dhsmith111/neato-build/docs/BOM.md

# Bill of Materials

## Neato Restoration
| Item | Source |
|---|---|
| NASTIMA 7.2V 5200mAh Li-ion Battery 2-pack | Amazon |
| Amazon Basics USB-A to Mini USB 2.0 Cable 3ft | Amazon |
| Filter + Brush Roll kit | Skipped for now |

## Raspberry Pi Core + AI
| Item | Source |
|---|---|
| CanaKit Pi 5 8GB GenAI Kit Assembled (Pi 5 8GB, AI HAT+ 2 Hailo-10H 40 TOPS, Turbine Case, Active Cooler, secondary Hailo fan, 128GB microSD, HDMI cables) | CanaKit |
| 27W GaN PD USB-C Power Supply with inline on/off switch | Amazon |

## Cameras
| Item | Source |
|---|---|
| Raspberry Pi Camera Module 3 Wide | pishop.us |
| Raspberry Pi Camera Module 3 Wide NoIR | pishop.us |
| Camera Cable for Raspberry Pi 5, 500mm x2 | pishop.us |

## Power & Wiring
| Item | Source |
|---|---|
| SunFounder 2 Channel DC 5V Relay Module | Amazon |
| ELEGOO 120pcs Dupont Wire Kit (M-F, M-M, F-F) | Amazon |
| Breadboard and Jumper Wires Kit (830 + 400 tie point) | Amazon |
| Ginsco 580pcs Heat Shrink Tubing Kit | Amazon |
| Yahboom PD Power Expansion Board for Pi 5 (6-24V in, 5V/5A PD out) | Amazon |

## Mounting & Wiring
| Item | Source |
|---|---|
| PATIKIL Sticky PCB Spacer Adhesive Standoffs 0.31" 24-pack | Amazon |
| Zip Tie Assortment multisize | Amazon |
| VELCRO Brand Heavy Duty Strips 4x2" 15 sets | Amazon |
| BNTECHGO 18 AWG Silicone Wire 5ft red + 5ft black | Amazon |
| HUIQIAODS Inline Fuse Holder 18 AWG + 5A fuse 2-pack | Amazon |
