dhsmith111/neato-build/(commit log)

2026-03-22 Add relay and serial test scripts, update requirements
    - relay_test.py: basic VBUS toggle test (fixed active_high=True)
    - serial_test.py: full power cycle + GetVersion over serial
    - requirements.txt: add gpiozero and lgpio (Pi 5 GPIO backend)
    [relay_test.py, serial_test.py]
2026-03-22 Add neato_serial library for Neato XV serial control
    Rename serial/ to neato_serial/ to avoid shadowing pyserial.
    Neato class wraps relay power cycle, serial connection, and all
    common commands (GetVersion, GetCharger, GetAccel, TestMode,
    SetMotor, GetLDSScan, SetLDSRotation, SetConfig).
    [neato.py]
2026-03-22 Add mounting layout diagram for Pi + camera on Neato
    SVG shows top and side views of component placement:
    Pi 5 + AI HAT+ 2 + camera stacked on LiDAR cover,
    relay and buck converter behind Pi toward rear.
2026-03-22 Add project documentation: BOM, power, wiring, setup
    Capture key technical decisions and hardware details in docs/:
    - BOM.md: complete parts list and costs
    - POWER.md: Yahboom PD board choice, battery specs, wiring plan
    - WIRING.md: relay pinout, serial, camera connections
    - SETUP.md: software stack, robot config, troubleshooting
    Update README power info and add docs links.
2026-03-22 Update README with full project description, clean up .gitignore
    Rewrite README with detailed project intro, architecture overview,
    and expanded stage descriptions. Add gitignore rules for test
    captures, lgpio temp files.
2026-03-22 Remove prices from public BOM, keep parts list only
2026-03-22 Remove LM2596 from BOM — replaced by Yahboom PD board
2026-03-22 Document venv --system-site-packages requirement for picamera2
    Add setup logs for all stages, document Hailo-10H driver install
    (h10- packages required, not generic hailo-), update BOM.
2026-03-22 Add vision pipeline: camera capture + YOLOv8m on Hailo-10H at 21 FPS
    Stage 3 core modules:
    - vision/capture.py: Camera class wrapping picamera2
    - vision/detector.py: Detector class using Hailo async InferModel API
    - vision/detect_test.py: single-frame detection test with bbox overlay
    - vision/benchmark.py: sustained FPS measurement (50 frames)
    Documented Hailo-10H API research in SETUP.md — the old InferVStreams
    API fails on H10, must use picamera2's Hailo wrapper (create_infer_model).
    [benchmark.py, capture.py, detect_test.py, detector.py]
2026-03-22 Add capture session manager and gitignore captures/
    - vision/session.py: timestamped folders under captures/ to prevent overwrites
    - .gitignore: exclude captures/ directory (test images only)
    [session.py]
2026-03-23 Add Stage 4: reactive obstacle avoidance + firmware behavior analysis
    Scout module — closed-loop detect-decide-drive pipeline:
    - scout/perception.py: fuse YOLO detections + hardware sensors into Snapshot
    - scout/rules.py: prioritized reactive rules (cliff > bumper > wall > pet > obstacle)
    - scout/driver.py: Action → Neato motor commands + dead-reckoning odometry
    - scout/sensors.py: background thread polls bumpers, wall IR, cliff, accel
    - scout/feedback.py: diagnostic LED + sound feedback per safety layer
    - scout/logger.py: session + breadcrumb logging for Stage 5 SLAM prep
    - main.py: orchestrator with capture → detect → perceive → decide → execute loop
    - config/scout.json: all tu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
    [analyze_clean_log.py, log_clean_mode.py, neato.py]
2026-04-05 Document battery power tap wiring for Yahboom PD board
    Documents the XV Signature Pro disassembly process, internal series
    battery wiring, Wago 221-413 tap method, and Yahboom KF301 connection.
2026-04-05 Add MOUNTING.md with 3D printed pod plan and component specs
    Documents electronics pod design intent, component dimensions, printer
    specs, and TODO list for when the Ender 3 calibration session happens.
2026-04-05 Update MOUNTING.md with OpenSCAD workflow for pod design
    Replace FreeCAD/Fusion360 with OpenSCAD code-based approach so Claude
    can write the design directly from measurements.
2026-04-05 Update MOUNTING.md with final pod layout and chassis measurements
    Reflects current temporary mounting state and planned three-pod permanent
    install. Includes physical chassis measurements, component-to-pod assignments,
    and cable routing plan. SCAD design tracked separately.
2026-05-09 Add FRONT_MOUNT_PROPOSAL.md — initial draft
    Captures motivation for shifting from rear-mount to front-mount,
    inherited and new constraints, open questions, and decision path.
    Rear-mount plan in MOUNTING.md remains documented approach until
    this proposal is accepted or rejected.
2026-05-09 Update FRONT_MOUNT_PROPOSAL.md with research findings and clarified mount approach
    - Added chassis/lidar/battery/bumper specs from online research, with
    caliper-needed items flagged.
    - Added "the bumper is a sensor array" finding: 4 forward IR rangefinders +
    4 bump switches + 2 cliff sensors + magnetic strip pickups all live in
    or behind the front bumper.
    - Clarified mount approach: velcro on the bumper face, electronics chassis
    rides with the bumper. Vertical band only — not too low, not too high,
    not near the sides.
    - Kept pod-level modularity: separate pod chassis per component along the
    front bumper, matching rear-pod design philosophy.
    - Critical feasibility question ident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
2026-05-09 Replace payload weight estimate with researched component table
    - Component weights from manufacturer specs and reputable retailers where
    available, marked with confidence levels.
    - Pi 5 + AI HAT+ 2 reflects user's actual config: bare boards, heatsink
    only, no plastic chassis, no active cooler.
    - Electronics + standoffs subtotal: ~225g (was estimated ~300g).
    - PLA shell weight is the remaining unknown — added action item to weigh
    the existing printed rear pods (print-PC-side task).
    - Added separate "weigh on kitchen scale" section to the measurement list.
2026-05-09 Clarify front-pod orientation: rotated 90 from rear pods
    - Pod's bumper-facing surface = ribbed velcro face (rear-pod "bottom").
    - Pod's forward-facing surface = open face (rear-pod "top").
    - Standoffs project forward from bumper; boards mount with components
    facing forward.
    - Camera lens naturally points forward without bracket re-orientation.
    - Added pod overhang clearance constraints (floor below bumper, upper
    chassis above bumper) and the corresponding clearance measurements
    to the must-measure list.
    - Noted standoff loading shifts from compression to cantilever shear
    in this orientation — fine for steady state but worth watching
    during bump events.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
2026-05-09 Add front-mount-layout.svg — top-down layout sketch
    First visual concretization of the front-mount approach. Shows pod
    arrangement (Yahboom outer-left, Pi+HAT center, relay inner-right,
    camera above-center), velcro bands on bumper-facing surfaces, cable
    runs with color coding, and the constraint zones (IR rangefinders,
    cliff sensors, bumper-side pinch zones).
    All sensor positions and pod dimensions are estimates pending caliper
    measurements on the actual robot. Legend and notes call out what's
    provisional. Includes alternative-layout note re: Yahboom outer-right
    to shorten the battery cable run.
2026-05-09 Correct sensor analysis: XV Signature Pro bumper has NO forward IR
    Verified against Neato Programmer's Manual sensor enums and multiple
    teardowns (RECESSIM, Fictiv, SparkFun): the XV Signature Pro front
    bumper contains only mechanical tactile microswitches. The earlier
    draft's "4 forward Sharp 0A51SK IR rangefinders behind the bumper"
    claim was wrong — it conflated the XV-11's side wall sensor with
    hypothetical front rangefinders.
    Actual sensor inventory:
    - 4 mechanical bump switches (LSIDEBIT/LFRONTBIT/RSIDEBIT/RFRONTBIT)
    - 1 IR wall sensor — SIDE-facing at the right-front corner, not
    forward through the bumper face
    - 2 cliff sensors on the chassis underside (not behind bumper)
    - 2 m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
2026-05-09 Confirm sensor analysis on physical unit (Board Rev 64, FW 3.4.24079)
    GetAnalogSensors and GetDigitalSensors verified live on the robot:
    - WallSensorInMM is the only forward-area sensor, side-facing at right-front corner
    - 4 mechanical bumper bits only, no forward IR rangefinders
    - Bumper face confirmed as pure mechanical interface
    - Pods can span full bumper face width without sensor occlusion concerns
2026-05-09 Drop rear-pod weighing tasks; record initial bumper measurements
    - Decision: skip weighing existing rear pods (different shell shape,
    not directly informative). PLA weights will come from first printed
    front pods instead.
    - Restructured measurements section into A-E groups with explicit
    fields per item.
    - Recorded measured A2 bumper face height = 61mm.
    - A1 width estimated at ~330mm (no caliper long enough to verify;
    visual estimate matches retailer specs).
    - A3 bumper-side pinch zone inset unknown — bumper sides are smooth
    with no visible seam; using ~20mm estimate.
    - B/C/D/E groups still pending — fields placed for incremental fill-in.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
2026-05-09 Record D1 floor clearance assumption (~5mm each way)
    D1 not directly measured — using ~5mm at rest with ~5mm additional
    margin during bumper depression as a working assumption. Pod bottom
    overhang must respect both numbers. Worth verifying physically when
    convenient; not blocking design work.
2026-05-09 Correct D1/D2: pod overhang allowances, not chassis clearances
    User clarified the ~5mm each way figure refers to how far the pod
    outer shell can extend above and below the bumper face without
    hitting anything — not chassis-feature clearances. Reframed D1/D2
    as pod vertical envelope allowances.
    Total pod vertical envelope = bumper face height (61mm) + 5mm above
    + 5mm below = ~71mm total pod height available.
2026-05-09 Lock in design envelope; mark unmeasured items as skipped
    User decision: no pod will extend to the bumper sides, so C1 (right-
    front-corner side wall sensor) is moot. B (bumper kinematics), C2/C3
    (cliff / magnetic strip sensors), and E1 (wheel axis to front edge)
    also marked as skipped — overkill for current design phase.
    Resolved bumper-face envelope:
    - Usable horizontal pod width: ~290mm (330 - 20 - 20)
    - Total pod vertical envelope: ~71mm (61 + 5 + 5)
    These two numbers plus the carried-over board specs and standoff
    patterns are the inputs to SCAD work. Remaining items (CG, drive
    geometry) deferred to post-prototype testing.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
2026-05-09 Fix SVG label collisions and overlap issues
    Layout problems in previous version:
    - Top view: battery cable label, pod names, cable labels, camera pod
    label all crammed into the same vertical band.
    - Side view: 5 right-side annotations had overlapping leader lines
    ending at nearly the same y-coordinate.
    - Notes column horizontally collided with legend column.
    Fixes:
    - Canvas widened to 900×1180.
    - Each label class gets its own dedicated y-row (battery cable,
    pod names, inter-pod cable labels, bumper face caption).
    - Camera pod relocated to upper-left of top-view block with label in
    open space to the right.
    - Side-view leader lines fan out to y-rows 30px apart.
    - Notes column shifted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
2026-05-09 Capture lessons from pod-design rear-pod work
    Reviewed pod-design branch (93 commits, ~20 of which are gusset
    iteration). Key findings:
    - Relay standoff pattern in this proposal was wrong (33.5x45mm).
    Corrected to 52.2x36.6mm per POD_DESIGN.md, which came from
    physical measurement.
    - Pi+HAT asymmetric hole placement (pi_x_left=6mm, pi_x_right=64mm)
    was hard-won — recorded explicitly so front-mount doesn't redo
    the measurement.
    - Gusset module took ~20 commits to get right; copy the proven
    version from hardware/right_pod.scad rather than re-deriving.
    - Geometry rotates 90 for front-mount: rear "pod_height" (vertical
    on chassis) becomes front "forward extent." Recommend using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
2026-05-09 Lock in pod design decisions: Pi in OEM case; Yahboom/relay 66mm walls
    Two design decisions captured today:
    1. Pi 5 + AI HAT+ 2 stays in its CanaKit Turbine Case (OEM enclosure)
    instead of being mounted on bare standoffs. Front Pi pod becomes a
    velcro tray + retention frame, not a custom board enclosure. The
    case is smaller than the bare-board pod we were sizing (~95mm vs
    ~110mm), gaining ~15mm of horizontal bumper budget. OEM case also
    provides full top/bottom/side protection, active cooling, and
    correct port openings — eliminates the port-aware wall design and
    the "electronics middle exposed" concern for the Pi pod.
    2. Yahboom and relay pods (bare-board, custom enc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
2026-05-09 Record measured Turbine Case dimensions (65 x 95 x 46, fully enclosed)
    User confirmed the OEM Turbine Case is totally enclosed and measured
    65 x 95 x 46mm. In front-pod orientation (case bottom against bumper):
    - 95mm horizontal width on bumper face — fits 290mm budget.
    - 65mm vertical height on bumper face — fits 71mm pod envelope.
    - 46mm forward extent — slightly more than bare-board target (30-40mm)
    but the trade-off buys full OEM enclosure and active cooling.
    "Totally enclosed" simplifies the Pi pod SCAD to just a velcro pad
    with retention features — no top/bottom walls, no port-aware structure,
    no standoffs. Just hold the case to the bumper.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
2026-05-09 Bring rear-pod SCAD in as cad/, rewrite MOUNTING.md for front-mount prototype
    - Pull right_pod.scad, inner_left_pod.scad, outer_left_pod.scad,
    all_pods.scad from pod-design branch into a new cad/ directory
    (was hardware/ on pod-design — renamed because the directory holds
    mechanical CAD, not hardware-interface code; "hardware/" namespace
    is reserved for future runtime drivers if needed).
    - Pull POD_DESIGN.md from pod-design with a status update noting the
    rear-mount install was never executed and the printed pods are now
    in front-mount prototype service (Pi NOT in its rear pod — Pi is
    in its OEM Turbine Case instead).
    - Rewrite MOUNTING.md to describe the front-mount protot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
    [all_pods.scad, inner_left_pod.scad, outer_left_pod.scad, right_pod.scad]
2026-05-09 Update README to reflect front-mount prototype
    - Mounting summary updated: front-bumper-mount with Pi in OEM case
    plus rear-pod prints for Yahboom and relay, velcro'd to bumper face.
    - Replaced top-of-LiDAR-cover narrative with front-mount narrative.
    - Docs section: link MOUNTING.md, FRONT_MOUNT_PROPOSAL.md, POD_DESIGN.md,
    and the new front-mount-layout.svg. Old mounting-layout.svg kept as
    "Original Top-Mount Sketch" historical reference.
2026-05-09 Record prototype observations: charging works, pods tilt, cables over-top
    Front-mount prototype is installed and partially validated:
    - Charging through dock confirmed working — the biggest functional
    risk that drove the move from rear-mount to front-mount is resolved.
    - Curved-shell pods (Yahboom and relay rear-mount prints) sit tilted
    on the flat bumper face, held by partial-contact velcro on the
    closer edge. Functional but not ideal long-term.
    - Battery cables routed over-the-top of the robot (over the lidar
    cover) rather than around the right side. Cleaner than planned.
    - Camera mounted on a separate small bracket in front of the Pi case
    and is now the frontmost point of the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
2026-05-09 Correct wrong assumption: rear pods are flat-bottomed boxes, not curved
    Multiple doc passages incorrectly described the rear-mount pods as
    having curved outer shells shaped to match the rear chassis. Looking
    at the actual SCAD: pods are rectangular boxes (e.g., outer_left_pod
    is pod_width=72 x pod_depth=71 x pod_height=66 with a flat ribbed
    bottom). They mount fine to flat surfaces.
    Whatever pod-tilt I read into the prototype photos must be from
    something else (cable tension, velcro alignment, or photo angle),
    not from curved shells.
    Fixed in MOUNTING.md (both the prototype description and the
    prototype observations) and FRONT_MOUNT_PROPOSAL.md ("What Changes"
    and "Design decisions" sectio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
2026-05-09 Add telemetry pipeline: metadata, summary, runs index
    scout/telemetry.py — new module:
    - collect_metadata(): interactive metadata prompt (room, lighting, obstacles, notes)
    - compute_summary(): per-run stats from raw frames (motion bucket, bumper
    events, wall sensor distribution, YOLO detection counts, tilt, battery)
    - update_runs_index(): maintains captures/runs.json as a top-level index of
    all runs, queryable without loading every sensor_log.json
    log_clean_mode.py:
    - New --watch flag: poll GetButtons over USB; when Start pressed, bounce
    USB so firmware can begin cleaning. One press, hands-off.
    - New --auto-start flag: send Clean over serial, then bounce USB. Firmware
    queues the s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
2026-05-10 Add pilot.py: interactive daemon for real-time robot driving
    - Unix-socket daemon keeps camera + Hailo NPU + serial open between
    commands, reducing look latency to ~1.3s vs ~5s one-shot
    - Vision-aware choose_action(): YOLO bbox_area as distance proxy,
    obstacle side detection, escalating bumper recovery
    - smooth_stop(): two-step decel to reduce forward tilt on stops
    - arc_turn(): differential wheel speed for smoother curves
    (modeled on firmware clean-run data: max 205mm/s, ~25mm/s increments)
    - read_lidar_summary(): 360° LDS scan parsed to cardinal distances;
    angle 0=rear, 180=front validated by physical test
    - WALL_MIN_VALID_MM guard: skip wall nudge when reading < 100mm
    (sensor r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
    [pilot.py]
2026-05-10 Refine pilot.py: LiDAR cross-reference, better distance thresholds, smooth decel
    - Raise BBOX_DANGER to 0.15 and BBOX_CAUTION to 0.10; calibrated against
    confirmed cases (vase at 70mm = 0.11, couch at 2m = 0.03-0.05)
    - Explore loop now reads LiDAR every 5 steps for ground-truth forward range;
    suppresses vision-danger overrides when LiDAR says front > 400mm clear
    (camera angle causes false positives for distant objects in other rooms)
    - smooth_stop() tuned: 8mm at 60mm/s before zero (from clean-run data)
    - arc_turn() added: differential wheel speed curves, smoother than pivot
    - LiDAR angle mapping validated: 0=rear, 180=front, 90=right, 270=left
    - WALL_MIN_VALID_MM guard: only act on wa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
2026-05-10 Add multi-threaded drive daemon, restructure repo
    drive/ — new module for autonomous driving
    daemon.py: parallel sensor/lidar/vision threads + DriveEngine + socket server
    client.py: thin client for sending commands
    pilot.py: legacy single-shot interface (kept for reference)
    firmware/ — Neato firmware analysis tools (moved from root)
    Key implementation lessons:
    - LDS rotation is OFF by default in TestMode — must SetLDSRotation On to get
    live LiDAR data (was returning frozen scans for hours)
    - Single SetMotor command per move lets firmware run its trapezoidal speed
    profile (accel + cruise + decel). Chunking into 120-150mm pieces forced
    abrupt stops because each chunk hit ze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
2026-05-10 Drive daemon improvements: safety, smoothness, photo capture
    - _drive_linear: single SetMotor command lets firmware run trapezoidal
    speed profile (accel + cruise + decel built-in). Inner loop checks
    is_blocked() at 20Hz and aborts via Speed 0 on bumper/cliff.
    - SensorThread: faster bumper polling (delay=0.08 vs 0.3) for tighter
    abort latency. ~230ms worst case bumper-to-stop at 100mm/s = ~23mm
    travel after impact.
    - LidarThread: re-checks _stop_event AND drive_idle.is_set() after wait
    to fix shutdown hang and serial race (from code review).
    - pivot/arc: zero-motor command in finally block so wheels always stop
    even on exception (from code review).
    - decide(): bumper recovery is b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
    [client.py, daemon.py]
2026-05-10 Fix log_clean_mode.py import path for firmware/ subdirectory
    sys.path.insert adds repo root so scout.* imports work when running
    from firmware/ after the file was moved from repo root.
    [log_clean_mode.py]
